kellyelaine677-max/TI2-FPGA-Piano/04_演示材料/演示口播稿_3分钟.md

# 演示视频口播稿 · 3 分钟版（照着念）

> 台词正文 **747 字**，中文正常语速 4.2 字/秒 ≈ **178 秒 = 2 分 58 秒**，实测统计值，不是估算。
> 每段标题上是「字数 / 本段秒数 / 累计秒数」，排练时开着秒表对累计那一列。
> **方括号 `[ ]` 是动作提示，不要念出来。**
> 所有拍摄/掐表提示都放在文末，正文部分可以直接整段复制到提词器。
> ⚠️ 数字是 2026-10-29 最新版（自测已从 8 个峰改为 **12 个峰**），旧文档里的数据已经过时，别照那份念。

---

## 镜 1 · 开场定位　64 字 / 15″ / 累计 0:15

> [手指向板子，相机给全景]

这是一台以 **FPGA** 为唯一计算平台的实时合成电子琴：32 复音并发，声音全部由 HDL 逻辑逐样本实时合成，经 **I2S** 送 DAC 发声，板上没有任何预录音频。

---

## 镜 2 · 三维交互　101 字 / 24″ / 累计 0:39

> [① 触摸条不同位置 ② 同一键轻按 vs 重压 ③ 手指在条上慢慢滑]

先看三维交互。

**第一维，音高**：手指按触摸条的不同位置，音就变了。

**第二维，力度**：同一个键，轻按和重压，音量、亮度明显不同 —— 采的是压力感应，不是开关量。

**第三维，表情**：手指在条上滑，音高连续滑动，这是滑音；编码器还能调颤音深度。这就满足了基础要求一。

---

## 镜 3 · 音色与和弦　97 字 / 23″ / 累计 1:02

> [转编码器 1 切音色 → 编码器 2 调大 release → 同时按 3~5 个键]

八种音色：正弦、方波、锯齿、三角、FM 调频、加法、八谐波、钢琴，是不同的合成算法，不是切换采样。

**ADSR** 四段实时可调：我把 release 调大，松开手，尾巴明显变长了。

多键同按是实时混音，增益按 255 除以根号 N 归一化，音多了也不削顶失真。

---

## 镜 4 · 自测模式　147 字 / 35″ / 累计 1:37　★ 全场最重要

> [同时按住矩阵键盘 key12 八度减 + key13 八度加约 0.5 秒。**不是编码器按钮**]
> ⏱ 触发后 0~8 秒先闭嘴：12 个音逐个点亮。第 8~12 秒讲十二个峰，第 12 秒起讲 32 复音　轴详见文末

现在进自测。

[第 8 秒，指频谱] 引擎自动输出**十二个已知频率**，从 110 到 5280 赫兹；屏幕上正好**十二个峰**，位置一一对应 —— 每个峰就是一个独立振荡器。这不是画上去的图：输入频率是我写死的，峰的位置就必须对得上。

[第 12 秒，32 音齐发] 接下来是**三十二个发声单元同时发声**，三十二个槽全部占满。

采样率等于系统时钟 40.5 兆除以 576，即 **70 312.5 赫兹**；按赛题公式，32 乘 70 312.5，约 **二百二十五万**，这个数现场可以验。

口径我也说清楚：谐波共享基频的相位累加器，这也是乐理上谐波的正确定义；按题目严格的独立累加器口径，我报 **32**。

---

## 镜 5 · 可视化　61 字 / 15″ / 累计 1:52

> [编码器 2 按键切显示模式 → 按八度关系的两个音]

LCD 上有三种可视化：李萨如 X-Y 图形 —— 按八度关系的两个音，出现 8 字形；12 路 **Goertzel** 滤波做的频谱；**WS2812** 灯条亮的位置，就是当前按的音级。

---

## 镜 6 · 蓝牙联动与 LED 引导　128 字 / 30″ / 累计 2:22

> [手机：连蓝牙 → 键位页改键 1 为 G → 传到琴 → 按板上第一个触摸键]

手机连上后可以蓝牙联动。键位能自定义：把第一个键改成 G，传到琴上，现在按板上第一个键 —— [按] 音从 C 变成了 G。

> [曲谱页 → 从网址导入 → 直接播放 → 点停止]

曲谱走局域网导入，**断网也能演**：选直接播放，板子照着谱子自己弹；点停止立刻静音。

> [切「引导」模式 → 跟着灯弹，中间故意弹错一个]

切到引导模式：**灯只亮当前该弹的那一个键**；我故意弹错，灯不动 —— 它是拿你按的键跟谱子做比对，不是按拍子自己往前跑。

---

## 镜 7 · 合规证明与收尾　149 字 / 35″ / 累计 2:58

> [切电脑，给资源报告特写]

最后是合规性。这是 Gowin 的资源报告：CLS 占用 97%，**块存储器 46 个全部用满**。

块存储里放的是一张 1024 点、16 位的正弦函数表 —— 一首 PCM 曲子要几兆字节，**物理上放不下一秒钟录音**。所有声音都是相位累加器、波表寻址、包络乘法实时算出来的。

时序：约束 40.5 兆，实际最高 **47.075 兆**，零违例。

> [回板子]

端到端延迟不到 0.3 毫秒 —— 远小于题目要求的 10 毫秒。我的演示到这里，谢谢。

---

# 以下为拍摄提示，不用念

## 镜 4 时间轴（自测全长约 17 秒，节奏固定）

| 触发后 | 画面 | 你在干什么 |
|---|---|---|
| 0 ~ 1.5 s | 静默预热 | 闭嘴等 |
| 1.5 ~ 8.1 s | 12 个音每 0.6 s 加一个，柱一个个亮 | 闭嘴，可以看屏幕 |
| **8.1 ~ 12.1 s** | **12 个峰全部亮起**（TS_CHORD 保持 4 s） | **开口讲十二个峰** |
| 12.1 s | 12 音松开 → 32 音齐发（128 个时钟，瞬间） | 短暂停顿 |
| **12.1 ~ 16.1 s** | **32 个发声单元齐发**（TS_HOLD 保持 4 s） | **讲 32 复音 + 吞吐量公式** |

> 嘴比画面快的话：这个镜头多留 5 秒静止特写，后期把台词往后挪，别抢画面。

## 必须背下来的 7 个数字（最新版）

| 数字 | 说法 |
|---|---|
| **32** | 复音数（严格口径：独立相位累加器数） |
| **70 312.5 Hz** | 采样率 = 40.5 MHz ÷ 576 |
| **≈ 225 万** | 32 × 70312.5，赛题吞吐量公式 |
| **12 个峰** | 自测频率 110/165/220/330/440/660/880/1320/1760/2640/3520/5280 Hz（**已由 8 个改为 12 个**） |
| **< 0.3 ms** | 端到端延迟（要求 ≤10 ms，拓展三 ≤5 ms） |
| **CLS 10050/10368（97%）、BSRAM 46/46（100%）** | 纯硬件 + 无预录 PCM |
| **Fmax 47.075 MHz**（约束 40.501 MHz，TNS=0） | 同步逻辑、延迟可预测 |

## 超时怎么办（按优先级删）

1. 删镜 5 整段（−14 秒）：可视化不是必答项，灯条在别的镜头里已经出现过。
2. 删镜 3 第三句"多键同按…归一化"（−8 秒）：保留和弦画面即可。
3. 删镜 6 曲谱那两句（−9 秒）：保留键位自定义 + LED 引导，拓展四已经演示到了。
4. 删镜 4 "这不是画上去的图…"（−8 秒）：但这句是防质疑的关键，能不删就不删。
5. **镜 4 的主体一个字都别删** —— 这是评分公式的现场证据。

## 开拍前检查清单

- [ ] 耳机/音箱插**板载耳机口**（声音从板子出，不是手机外放）
- [ ] 烧的是**正常固件**，不是 TX 自检版（自检版上电会自己一直发 C4）
- [ ] JDY-16 的 **RXD → 板 T8** 这根线接牢（回传命脉）；模块 **PWRC 悬空，别接地**
- [ ] 电脑 `scores\启动曲谱服务器.bat` 已跑起来，窗口别关，记下它打印的网址
- [ ] 手机系统录屏已开；蓝牙、定位、权限全开；关掉会弹通知的 App
- [ ] 相机固定别手持 —— 频谱只有 240×96 像素，一抖就看不清 12 个峰
- [ ] LCD 是反光屏，灯不要正对着照；拍不清就偏一点角度并手动锁焦

## 两处最容易翻车的地方

1. **自测按不出声** —— 一定是按错键。触发是 **key12（八度减）+ key13（八度加）同时按住约 0.5 秒**，不是编码器按钮：编码器那根引脚在这块板上实测读到低电平，我刻意没用它做触发。
2. **镜 4 讲太快** —— 见上面时间轴表，第 8 秒和第 12 秒是两个开口点，别提前。
