kellyelaine677-max/TI2-FPGA-Piano/05_作品海报/TI2电子琴作品海报_A3.pptx

TI2 电子琴

FPGA 实时多音色合成电子乐器引擎

张翔　骆善轩　方旭亮

队伍编号 48771

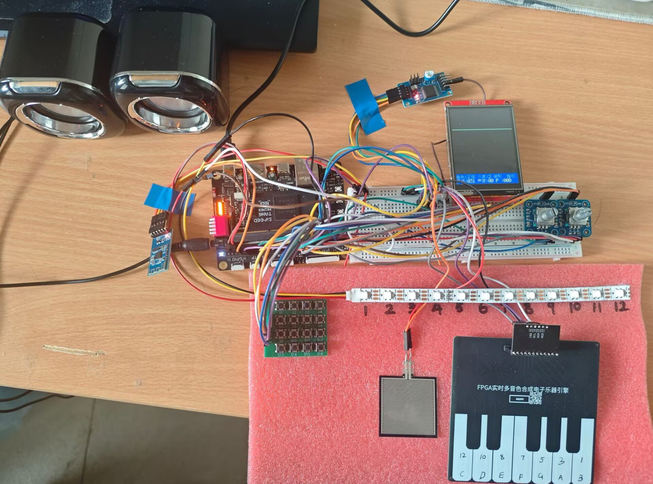
[picture p1: figure]

01

时分复用

32 声部轮转共享一套运算单元，仅 5 个 DSP

02

零采样合成

一张 1024×16 正弦表派生 8 种音色

03

实时自证

12 路 Goertzel 现场验频谱，可数 12 峰

32

复音数

70312.5

采样率 Hz

2.25×10⁶

振荡器每秒

<0.3

延迟 ms

47.075

Fmax MHz

46/46

块存储器
