kellyelaine677-max/TI2-FPGA-Piano/03_硬件接线/BT_WIRING.md

# 蓝牙模块接线与通信协议说明

对应拓展要求 4：蓝牙模块与手机 App 联动、在线曲谱下载、演奏键位自定义、
演奏录音回传。

链路上传的是**标准 MIDI 字节流**，串口 **9600 8N1**。手机端任意能发字节的
串口工具都能驱动本琴，不需要自定义私有协议。

---

## 1. 模块选型

### 1.1 HC-06（本工程默认）

经典蓝牙 SPP 从机模块。与 HC-05 的区别：

| | HC-06 | HC-05 |
|---|---|---|
| 角色 | 只能从机 | 主从可切 |
| 默认波特率 | 9600 | 38400（AT 模式）/ 9600（数据模式） |
| 配置方式 | 未配对时发 AT 命令，无换行 | 需拉高 KEY 脚进 AT 模式 |

本工程按 HC-06 出厂默认 9600 设计，开箱即用，不需要 AT 配置。
FPGA 侧分频常量为 `BT_CPB = 4219`（40.5 MHz / 9600）。

若改用 115200：未配对状态下发 `AT+BAUD8`（无回车无换行），
并把 `top_synth.v` 里的 `BT_CPB` 改为 `352`。

### 1.2 备选：JDY-16（BLE 4.2，兼容 iOS）

HC-06 走 SPP，**iOS 不支持 SPP**；若使用 iPhone 需换 BLE 透传模块。
JDY-16 是同规格的串口透传模块，仅链路层为 BLE，**接线与波特率完全一致，
FPGA 代码无需改动**，只换手机端走 BLE。

| | HC-06 | JDY-16 |
|---|---|---|
| 协议 | 经典蓝牙 SPP | BLE 4.2 |
| iPhone | 不支持 | 支持 |
| 默认波特率 | 9600 | 9600（`AT+BAUD4`） |
| 服务 / 特征 UUID | — | `FFE0` / `FFE1` |
| AT 命令结尾 | 无换行 | 必须 `\r\n` |
| 逻辑电平 | 3.3 V | 3.3 V |
| 单包有效负载 | 字节流，无限制 | 20 字节（MTU 23 − 3） |

**使用要点：**

**① 供电：区分「模块本体」与「底板」的电压标注。**

| 版本 | 丝印/手册标注的 VCC | 含义 |
|---|---|---|
| 排针版（无底板） | 1.8~3.6 V | 模块本体电压，接 +3V3 |
| 带底板版 | 3.6~6 V | 底板上 LDO 的输入范围，非 IO 电平 |

模块本体恒为 3.3 V 供电，因此 TXD/RXD 一定是 3.3 V TTL，与底板丝印无关。
带底板版只是多一颗 LDO 把 5 V 降到 3.3 V，不影响逻辑电平。三种接法：

- **A（推荐）：底板 VCC 脚接 +3V3。** 底板上多为 XC6206 / ME6211 一类低压差
  LDO（压差 0.1~0.3 V），3.3 V 输入可输出约 3.0 V，在模块 1.8~3.6 V 范围内。
  用万用表量模块第 1 脚（VCC），≥2.7 V 即可。若底板是 AMS1117-3.3
  （压差约 1.1 V），输出会掉到 2.2 V，改用方案 B。
- **B：底板接 5 V。** Dock 的 J5/J6/J12/J14 四个座子只有 +3V3，5 V 需另外取
  （核心板 8P 调试口的 5V0，或外置 5 V，**必须与板子共地**）。接上后需量
  模块 TXD 空闲电压：正常约 3.3 V；若为 5 V（底板含 5 V 电平转换），
  **必须加分压**后才能接 FPGA。
- **C：绕开底板 LDO。** 底板 VCC 输入脚悬空，+3V3 直接焊到模块第 1 脚 VCC
  或底板背面 LDO 输出端。

排针版（无底板）最省事，直接接 +3V3。

**② SELECT 脚（21）必须悬空。** 接地会切换到 IIC 模式，串口功能失效。

**③ 关闭上电状态串输出。** 出厂 `AT+ENLOG1` 会向 TXD 打印 `+CONNECTED`
一类 ASCII，混入 MIDI 字节流。首次配置需关闭：

```
AT+ENLOG0\r\n       关状态串输出
AT+NAMETI2-PIANO\r\n
AT+STARTEN0\r\n     上电即工作，不做"连接才唤醒"
AT+PASS1234\r\n
AT+BAUD4\r\n        确认 9600
AT+RST\r\n
```

**④ 其余引脚可不接。** 最小可用接线为 VCC / GND / TXD / RXD 四根：

| 脚 | 处理 | 说明 |
|---|---|---|
| STAT（6） | 悬空 | 连接状态指示：UART 模式下未连接为低、已连接为高。可串 1 kΩ 接 LED 阳极，LED 阴极接地 |
| PWRC（22） | 悬空或 10 kΩ 上拉到模块 VCC | AT 模式选择脚：高/悬空为透传模式；低电平进入 AT 指令模式，此时手机发来的 MIDI 字节会被当作 AT 命令消费，琴无响应 |
| RESET（23） | 不接 | 硬件复位，需要复位时发 `AT+RST` |
| PWM1~4 / IO1~4 | 不接 | 控灯、控电机用，本项目不涉及 |
| SELECT（21） | 必须悬空 | 接地会切换为 IIC 模式 |

上拉或外接时只能接 3.3 V。带底板版若给底板 VCC 供 5 V，PWRC 不可接到该
5 V 上——模块 IO 属 3.3 V 电平域。应接模块第 1 脚的 VCC（3.3 V）。

**⑤ BLE 的 20 字节分包。** 曲谱 SysEx 最长 68 字节，超过单包上限，
手机端需切片并按序写入（App 的 `BleTransport.write()` 已处理：按 `MTU−3`
切片，等待上一个 `onCharacteristicWrite` 回调后再发下一片）。
板上 `midi_rx.v` 逐字节解析，分包不影响结果。

### 1.3 可替换的 BLE 模块

以下型号可直接替换，App 代码无需改动（`BleTransport` 已支持 `FFE0/FFE1`
与 Nordic UART 两种 UUID）：

| 型号 | 芯片 | 模块本体 VCC | 默认波特率 | UUID | 备注 |
|---|---|---|---|---|---|
| HM-10 / MLT-BT05 | CC2541 | 3.3 V | 9600 | FFE0/FFE1 | 出厂即 9600，与 `BT_CPB=4219` 直接对应，AT 命令不带换行 |
| JDY-08 | CC2541 | 3 V / 3.3 V | 115200 | FFE0/FFE1 | 需先 `AT+BOUD4` 改为 9600；吞吐约 1 KB/s |
| JDY-31 | — | 3.3 V | 9600 | FFE0/FFE1 | BLE 5.0 |
| JDY-16 | nRF51822 | 1.8~3.6 V | 9600 | FFE0/FFE1 | AT 命令必须带 `\r\n` |

选型硬指标：**模块本体 VCC 为 3.3 V**，则 TX/RX 为 3.3 V TTL，
可直接连 FPGA。底板丝印的 3.6~6 V 仅表示其 LDO 输入范围。
不确定时用万用表量模块 TXD 空闲电压，≤3.3 V 即可安全连接。

---

## 2. 接线

蓝牙两根信号线固定在 **PMOD0 座**：该座每个针脚旁都印有球号
（`T6 P6 R8 T7 / T8 P8 P9 T9`），八个脚全部空闲、全部位于 bank 3、
全部为 LVCMOS33 3.3 V，按丝印即可接线。

| HC-06 / JDY-16 | FPGA（Tang Primer 20K Dock） |
|---|---|
| VCC | PMOD0 的 VCC（先确认是 3.3 V；带底板版需 5 V 时见 1.2 方案 B） |
| GND | PMOD0 的 GND（必须共地） |
| TXD | PMOD0 丝印 `T6` 的针脚（`bt_rxd`） |
| RXD | PMOD0 丝印 `T8` 的针脚（`bt_txd`） |

**两点必须确认：**

**① 逻辑电平。** HC-06 芯片本身为 3.3 V，但市面部分底板带 5 V 电平。
若模块 TX 为 5 V，**必须加分压**（例如 2 kΩ + 1 kΩ 串联到地，从中间取
3.3 V），否则可能损坏 FPGA 的 3.3 V IO。上电前用万用表量模块 TX 空闲电压，
应接近 3.3 V 而非 5 V。

**② 保留 `IO_LOC` 约束。** `.cst` 中这两个信号同时给出 `IO_TYPE` 与
`IO_LOC`。只写 `IO_TYPE=LVCMOS33` 而不锁位置时，工具会分配到 R6
（bank 4、LVCMOS18、1.8 V），接 3.3 V 模块会损坏 FPGA。
编译后可在 `impl/pnr/project.pin.html` 中核对：`bt_rxd` 为 `T6/3`、
`bt_txd` 为 `T8/3`，Bank 电压列均为 3.3。

---

## 3. 通信协议

### 3.1 手机 → 琴：演奏

```
0x90 <音号> <力度>    起音（力度为 0 时按停音处理）
0x80 <音号> <力度>    停音
```

- 音号为绝对 MIDI 音高（0~127），不受板上八度键影响，八度由 App 决定
- 支持 running status（省略状态字节）
- 力度固定写 100，引擎侧不使用该字段（板上力度为常量）

### 3.2 手机 → 琴：曲谱播放方式（CC 32）

```
B0 20 00    直接播放：板子自行演奏
B0 20 01    引导模式：仅点亮 LED 等待弹奏，板子不发声
```

必须在 SysEx 之前发送——板子收到 `F7` 会立即开始播放。
App 曲谱页已排好顺序（先 CC 32 后 SysEx）。

### 3.3 手机 → 琴：播放开关（CC 34）

```
B0 22 00    停止并从头复位（song_player 会补发 note_off 清除残音）
B0 22 01    播放
```

板子播放结束后从头循环，不自动停止。App 端按曲子总时长计时，
放完自动发 `B0 22 00`；曲谱页也提供「停止播放」按钮。

### 3.4 手机 → 琴：键位自定义

```
CC 20 → 槽 0，CC 21 → 槽 1，……，CC 31 → 槽 11
值 0~11 = 该槽对应的音级偏移
```

即发送 `0xB0 0x14 <值>` 把 0 号槽映射到指定音级。默认为恒等映射
（槽 i → 音级 i）。

该映射只影响起音；停音使用按下时锁存的实际音号，因此按住键时修改映射
不会留下卡音。

### 3.5 手机 → 琴：音色选择（CC 33）

```
B0 21 <0..7>
```

| 值 | 音色 | 值 | 音色 |
|---|---|---|---|
| 0 | 正弦 | 4 | FM |
| 1 | 方波 | 5 | 加法合成 |
| 2 | 锯齿 | 6 | 八谐波加法 |
| 3 | 三角 | 7 | 钢琴 |

与琴上 EC11 编码器 1（旋转）、键盘 key14 操作的是同一个 `timbre` 寄存器，
手机切换后板载 LCD 与丝印 LED0~2 同步变化。顺序严格对应
`voice_engine.v` 的 `TIM_SINE..TIM_PIANO`。

板上无 EEPROM，音色掉电回到 0（正弦），因此 App 每次连接时自动重发一次
（`Link.pushSettings()`）。App 中选择的音色存在手机 SharedPreferences。

### 3.6 手机 → 琴：曲谱下载（SysEx）

```
F0 7D 01 <音符数N> <b0> <b1> ... <b(N-1)> F7
```

每个音符字节取 7 位：`[6:4]` 为音级（0~6 对应 C D E F G A B，
**7 = 休止符**），`[3:0]` 为时值，**单位半拍**（1 = 八分音符、2 = 四分音符、
4 = 二分音符，取值范围 1~15）。一个单位 175 ms。

- 收到 `<音符数>` 时清除"已加载"标志，并把 `song_mode` 拉回 0
  （下载期间停止播放并复位指针）
- 收到 `F7` 才提交，且提交后立即自动开始播放，无需再长按 key13+key14
- 停止方式：长按 key13+key14 切换一次曲目模式（`song_mode` 翻回 0）
- 实现上由 `sc_start` 置 0 / `sc_end` 置 1 直接驱动 `song_mode`
  （见 `top_synth.v` 键盘块末尾）。该复用是有意的：另建 `sc_autoplay`
  标志会使 CLS 上升到 10171/10368（99%），导致布线失败
- 最多 64 个音符
- 未下载曲谱时播放内置 42 音旋律

### 3.7 琴 → 手机：录音回传

板子把每个音符事件即时打成 3 字节 MIDI 流式送出：

```
0x90 <音号> 0x40     起音
0x80 <音号> 0x00     停音
```

录音保存在手机 App，板上不设缓冲（BSRAM 已占满）。
自检（M6）期间不发送，避免与演示音流冲突。

---

## 4. 板上曲谱播放器的状态机设计

`song_player.v` 的状态机在以下几个出口都需保证与引擎的音符状态一致，
否则会残留长音或无法起播：

- `sounding` 仅在真正向引擎提交音符时置 1（`!guide_only && deg != 7`），
  引导模式下不置 1
- 停止、切换引导模式时，若 `sounding` 为 1 则补发一次 `note_off` 收尾
- 拍点到期的 `note_off` 不受 `guide_only` 约束（`sounding=1` 即表示引擎中有音）
- `!enable` 分支把 `pend` 置 1，使 `enable` 拉高后下一拍即可发出第一个音。
  若复位分支把 `pend` 清 0，而 `pend` 的另一来源又依赖 `sounding`，
  两者互锁会导致起播死锁
- 时值计数用 `dur_left <= bts_now - 1`（为 0 时保持 0）。若直接取
  `bts_now`，拍点先减到 0、再等一个拍点才发 `note_off`，每个音会多延一拍

---

## 5. UART 分频常量的位宽

`uart_rx.v` / `uart_tx.v` 中 `CPB`、`HALF` 与计数器均取 **16 位**。
`BT_CPB = 4219` 的二进制为 13 位，若按 9 位截取只剩 123，`HALF` 由 2109
变为 61，接收器实际波特率约为 40.5 MHz / 123 ≈ 329 kbaud。

此时起始位与停止位判据仍可能偶然成立，接收器照样输出 `dout_valid`，
但解出的是乱码，`midi_rx` 不会产生 `note_on`——表现为诊断灯闪烁而无声。
综合、布线、时序均不报错，属于静默失败。

凡分频、计数类常量，位宽应按最大可能取值预留，不能按当前取值刚好装得下
来给。

9600 接收器在发送端为 115200 / 19200 时解不出任何字节，因此诊断灯完全不闪
说明速率相差过大；灯闪但无声音说明采样点错误。

---

## 6. 板载诊断灯

| 丝印 | 平时显示 | 触发时 |
|---|---|---|
| LED0 | timbre[2]（音色） | 收到任一蓝牙字节后翻转，保持约 150 ms |
| LED5 | 活跃复音数的 bit0 | 解出一个 note on / off 后翻转，保持约 400 ms |

采用翻转而非点亮：LED0 平时显示 `timbre[2]`，音色 0~3 时本就为亮、
音色 4~7 时本就为灭，固定写"亮"在音色 0~3 时无法观察到变化。

板载共 6 个 LED，丝印从左到右为 LED0→LED5。LED0 在最左（音色组），
LED5 在最右（复音数组），与"按几个键亮几个"的复音数指示不是同一组。

在 App 诊断中点「发一个测试音」（发 `90 3C 40` + `80 3C 00`，共 6 字节），
观察两灯：

| LED0（收到字节） | LED5（解出音符） | 结论 |
|---|---|---|
| 翻转 | 翻转 | 链路正常，音符已进入引擎 |
| 翻转 | 不翻转 | 字节为乱码（采样点错误）。发 `AT+BAUD4` 强制回到 9600 |
| 不翻转 | 不翻转 | 字节未到达 FPGA，见下方排查表 |
| 连接瞬间持续闪 | — | 正常：App 自动重发 12 条键位 CC（36 字节），叠加模块的 `AT+ENLOG1` 状态串 |

---

## 7. 故障排查顺序

| # | 检查项 | 说明 |
|---|---|---|
| 1 | FPGA 是否为最新 bitstream | 蓝牙引脚固定在 T6 / T8，旧版本 `bt_rxd` 位置不同，线插在 T6 上不会响应。烧录 `impl/pnr/gowin_ti2.fs` 后再试 |
| 2 | TXD / RXD 是否接反 | 模块 TXD → T6，模块 RXD → T8。接反时模块收不到数据 |
| 3 | JDY-16 是否发过 `AT+ENLOG0` | 未关闭时模块会向 TXD 打印 `+CONNECTED` 一类 ASCII，混入 MIDI 字节流 |
| 4 | PWRC 是否接地 | 接地进入 AT 指令模式，手机发来的 MIDI 字节被当作命令消费，表现为"已连接但无响应" |
| 5 | 是否共地 | 只接信号不接 GND 一定不通 |
| 6 | 波特率 | HC-06 与 JDY-16 出厂均为 9600（对应 `BT_CPB=4219`）。模块被改过波特率则不通用，可用 `AT+BAUD4` 改回 |

判断链路是否连通：在 App 的「键位」页点「重新发送」，会连发 12 条 CC。
若板上键位随之改变，说明链路通畅，问题在别处。

---

## 8. 自测步骤

1. 烧录 `impl/pnr/gowin_ti2.fs`
2. 上电，压力板上不要放置物体（首次 ADC 读数被当作静止零点）
3. 手机配对 HC-06（默认配对码通常为 1234 或 0000）
4. 用蓝牙串口 App 连接，切到十六进制发送模式
5. 发 `90 3C 40` → 应响一个音（C4 = 60）；再发 `80 3C 00` → 停
6. 发 `B0 14 07` → 把 0 号槽改为半音 7（G），按键盘第一个键验证。
   （CC 值 0~11 是半音偏移而非音级：0=C 1=C# 2=D … 4=E … 7=G 11=B）
7. 发 `B0 21 07` → 切为钢琴音色（`B0 21 00` 回正弦）
8. 发 `F0 7D 01 02 01 22 F7` → 下载一首 2 音的曲子
   （`01` = 音级 0（C）持续 1 拍，`22` = 音级 2（E）持续 2 拍），
   发送完成后自动开始播放，无需再按板上的曲目键

---

## 9. 已知限制

- HC-06 为从机，只能由手机主动连接，板子不能主动回连
- 经典蓝牙 SPP 在 iOS 上不可用；iPhone 场景改用 JDY-16 一类 BLE 模块
  （接法不变，见 1.2）
- 录音回传的是音符事件而非音频：音频 70312.5 Hz × 16 bit = 1.4 Mbps，
  9600 波特无法承载
- 曲谱上限 64 音，且编码中没有八度位（每音符 7 位 = 3 位音级 + 4 位时值），
  只能表示单个八度内的旋律
- 键位自定义掉电丢失（板上无 EEPROM），由手机端连接时重发来弥补

---

## 10. 演示流程

1. 上电（压力板上不放置物体，首帧 ADC 会被采为零点）
2. 手机打开 TI2 电子琴 → 连接 `TI2-PIANO`
3. **演奏**：按 App 键盘 → 琴响；松开 → 停；两指同时按 → 和弦
4. **键位自定义**：键位页把「键 1」改为 G → 按板上第一个触摸键，音高改变
5. **在线曲谱下载**：曲谱页点「从网络导入」→ 下载 → 开启 LED 曲目指引，
   LED 按新曲谱走、琴按新曲谱响
6. **录音**：弹奏一段 → 录音页点「回放」，琴自动重演 → 点「导出 .mid」，
   导出文件可在电脑上用任意 DAW 打开

**兜底方案**：链路上传的是标准 MIDI over UART。若现场 2.4 GHz 干扰严重
导致蓝牙连不上，可直接插 CH340 USB-TTL，用电脑串口助手发送同样的字节
（`90 3C 40`、`B0 14 07`、`F0 7D 01 02 01 22 F7`），功能演示同样成立。

---

## 11. 配套 Android 工程

配套 App 源码见 `02_AndroidApp/`（Kotlin，Android Studio 直接打开）。
同时支持 SPP 与 BLE 两种传输，HC-06 与 JDY-16 均可连接。四个页面对应四个子项：

| 页面 | 功能 |
|---|---|
| 演奏 | 12 键键盘，支持多指和弦；按下发 `90 nn 40`，松开发 `80 nn 00` |
| 键位 | 12 个槽各自选音（CC 20~31）。设置存于手机，每次连接自动重发 |
| 曲谱 | 内置曲目 + 从网址导入 JSON，一键下发 SysEx |
| 录音 | 接收事件 → 打时间戳 → 存标准 `.mid` → 可回放、可导出到 DAW |
